PCARS/PCARS_Band_Display/hardware/V2/Mechanical_CAD/Mechanical_Stack_Up.dxf

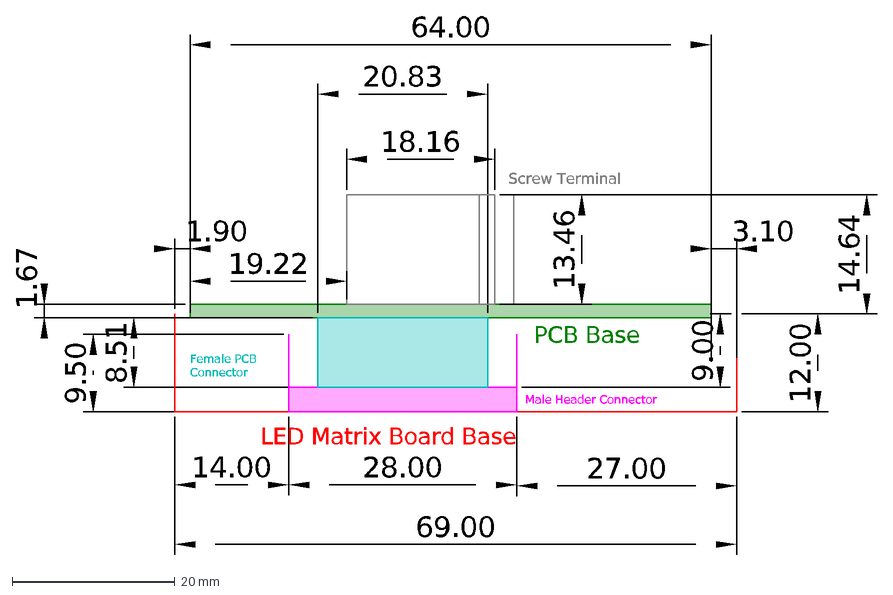
[picture p1: CAD file, 2025-04-22]
hardware/V2/Mechanical_CAD/Mechanical_Stack_Up.dxf
PCB Base
64.00
12.00
14.00
28.00
9.50
69.00
27.00
1.90
9.00
20.83
8.51
Male Header Connector
Female PCB Connector
LED Matrix Board Base
1.67
13.46
19.22
18.16
14.64
3.10
Screw Terminal
